Benv-B/photo-frame-hardware/hardware/iris_xiao_c5_revC/output/pcb/board_bottom.png

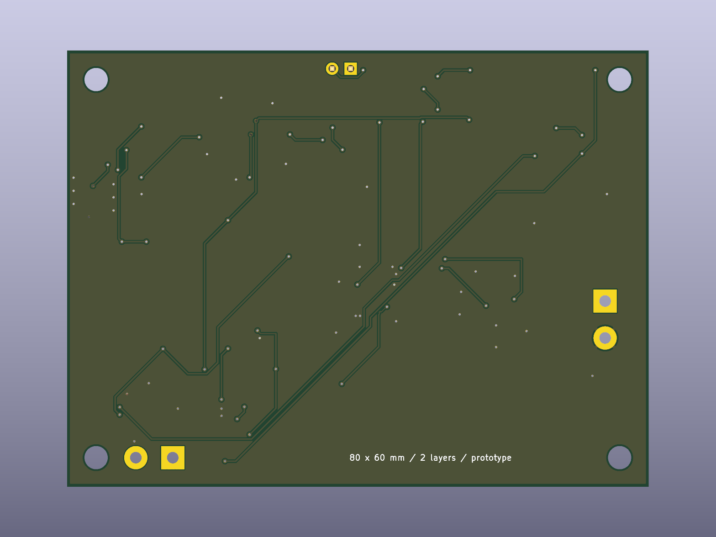
hardware/iris_xiao_c5_revC/output/pcb/board_bottom.png
