Benv-B/photo-frame-hardware/hardware/iris_xiao_c5_revC/output/pcb/bottom_copper.png

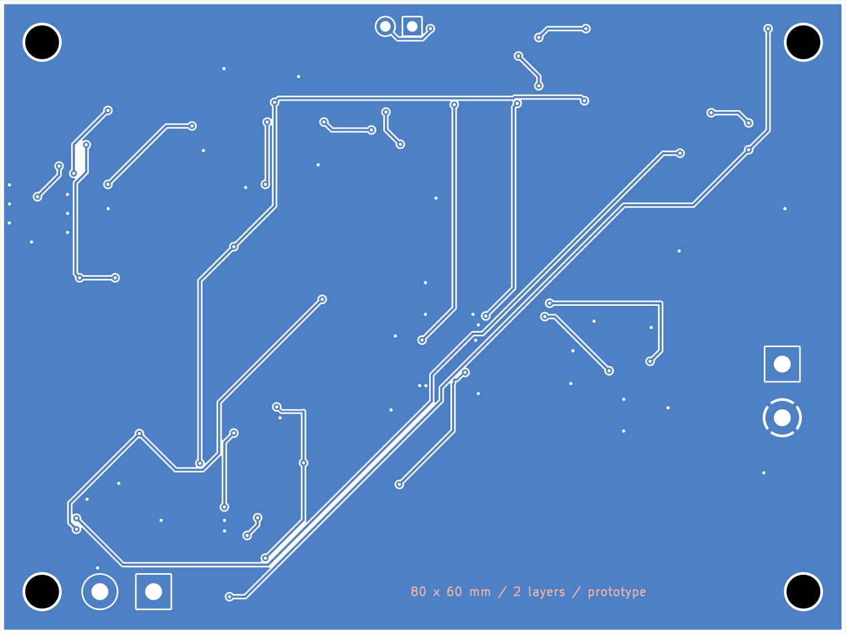
hardware/iris_xiao_c5_revC/output/pcb/bottom_copper.png
