Benv-B/photo-frame-hardware/hardware/iris_xiao_c5_revC/output/pcb/top_copper.png

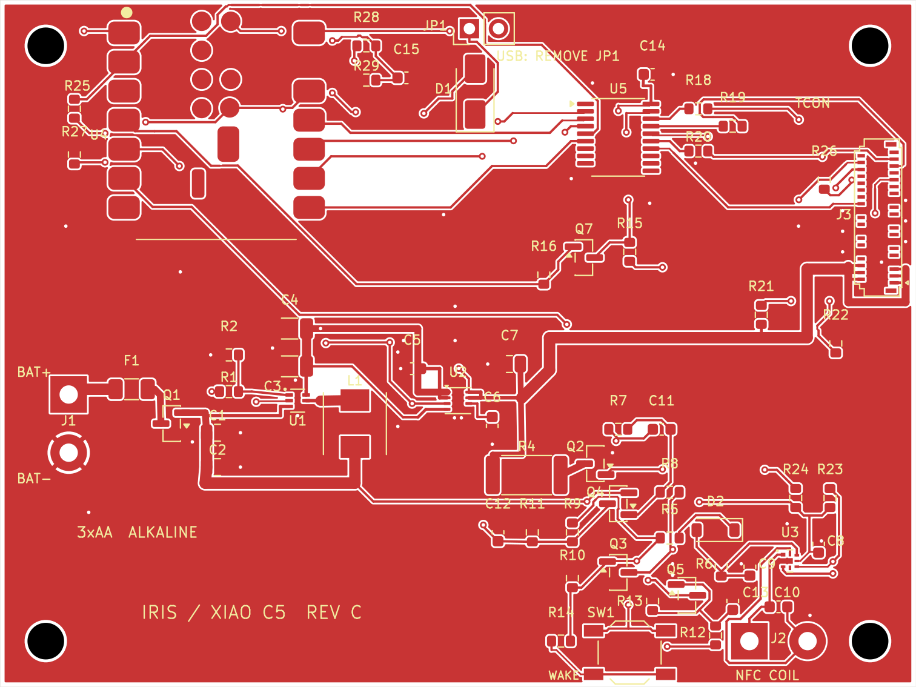
hardware/iris_xiao_c5_revC/output/pcb/top_copper.png
