Benv-B/photo-frame-hardware/hardware/iris_xiao_c5_revC/output/preview/page_1.png

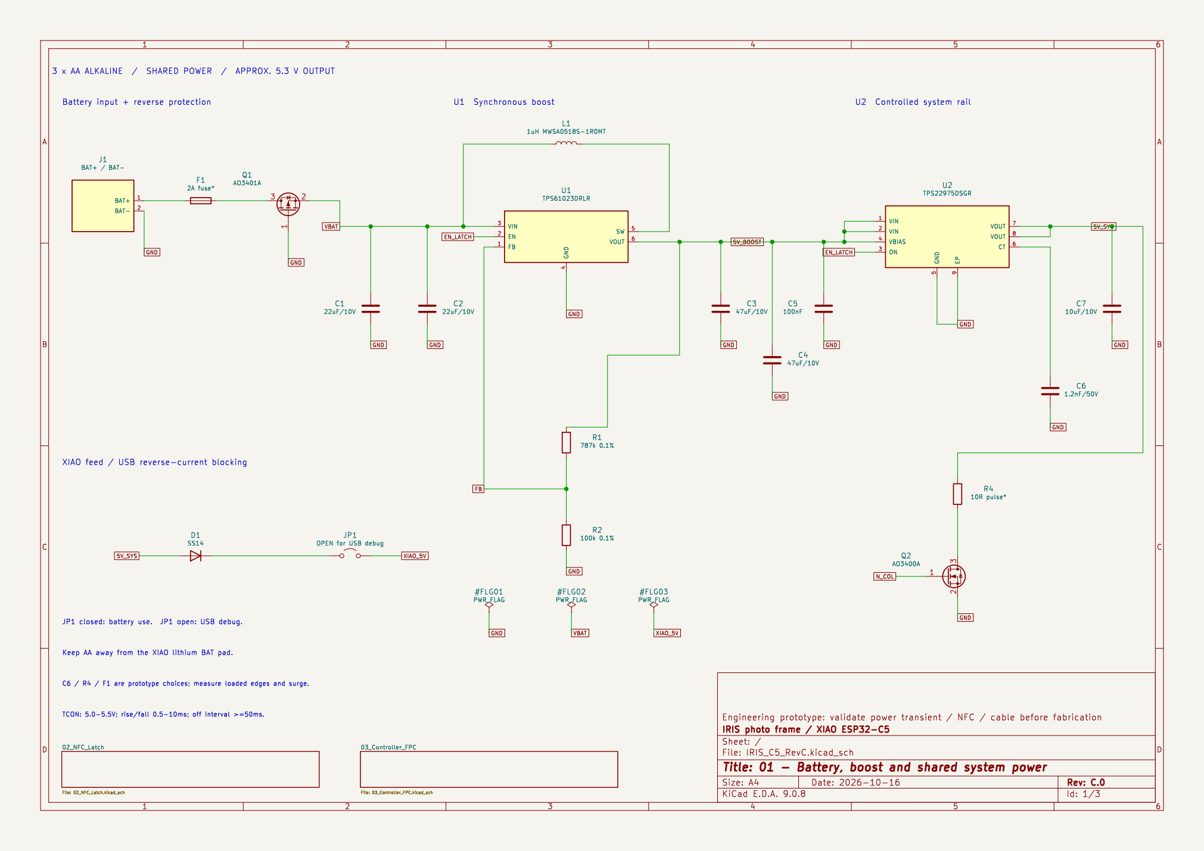
hardware/iris_xiao_c5_revC/output/preview/page_1.png
