Benv-B/photo-frame-hardware/hardware/iris_xiao_c5_revC/output/BOM.csv

Reference | Value | Footprint | Sheet | Notes
J1 | BAT+ / BAT- | IRIS_Local:Battery_Wire_2P | 1
F1 | 2A fuse* | Fuse:Fuse_1206_3216Metric | 1 | Candidate; verify fuse pulse I2t with measured TCON inrush
Q1 | AO3401A | Package_TO_SOT_SMD:SOT-23 | 1 | Reverse polarity protection: source is protected side
U1 | TPS61023DRLR | IRIS_Local:TI_DRL0006A | 1 | C919459; six-pin TI DRL0006A; no PG; 0.595V nominal feedback
L1 | 1uH MWSA0518S-1R0MT | IRIS_Local:Sunlord_MWSA0518S | 1 | C408343; Sunlord, Irms 8A, Isat 9A, DCR17mOhm; original land pattern
C1 | 22uF/10V | Capacitor_SMD:C_0805_2012Metric | 1
C2 | 22uF/10V | Capacitor_SMD:C_0805_2012Metric | 1
U2 | TPS22975DSGR | IRIS_Local:Texas_DSG0008A_WSON-8-1EP_2x2mm_P0.5mm_EP0.9x1.6mm | 1 | ON follows hardware latch directly; no power-good detector
C3 | 47uF/10V | Capacitor_SMD:C_1206_3216Metric | 1
C4 | 47uF/10V | Capacitor_SMD:C_1206_3216Metric | 1
C5 | 100nF | Capacitor_SMD:C_0603_1608Metric | 1
R1 | 787k 0.1% | Resistor_SMD:R_0603_1608Metric | 1 | PWM nominal 5.27765V; PFM nominal +1% ~5.33V
R2 | 100k 0.1% | Resistor_SMD:R_0603_1608Metric | 1
C7 | 10uF/10V | Capacitor_SMD:C_0805_2012Metric | 1
C6 | 1.2nF/50V | Capacitor_SMD:C_0603_1608Metric | 1
R4 | 10R pulse* | Resistor_SMD:R_2512_6332Metric | 1 | Pulse energy includes C*V^2/2 plus supply/discharge overlap (~2.76mJ/ms); validate actual waveforms and resistor pulse curve
Q2 | AO3400A | Package_TO_SOT_SMD:SOT-23 | 1 | N_COL high when latch OFF; verify discharge/load-switch order
D1 | SS14 | Diode_SMD:D_SMA | 1 | Anode at SYS; cathode toward XIAO. Blocks USB backfeed to SYS.
JP1 | OPEN for USB debug | Connector_PinHeader_2.54mm:PinHeader_1x02_P2.54mm_Vertical | 1
J2 | Tuned 13.56MHz coil | IRIS_Local:Battery_Wire_2P | 2 | Remote antenna; tune with screen/enclosure/ferrite
U3 | NT3H2111W0FHKH | IRIS_Local:NXP_SOT902-3_XQFN8_1.6x1.6mm | 2 | C710403; SOT902-3 XQFN8; no center solder pad; FD unused
C10 | DNP / tune | Capacitor_SMD:C_0603_1608Metric | 2
C8 | 100nF | Capacitor_SMD:C_0603_1608Metric | 2
R24 | 4.7k | Resistor_SMD:R_0603_1608Metric | 2
R23 | 4.7k | Resistor_SMD:R_0603_1608Metric | 2
C9 | 180nF* | Capacitor_SMD:C_0603_1608Metric | 2
R6 | 470k | Resistor_SMD:R_0603_1608Metric | 2
D2 | 1N4148W | Diode_SMD:D_SOD-123 | 2
R5 | 22k | Resistor_SMD:R_0603_1608Metric | 2
Q3 | BC847B | Package_TO_SOT_SMD:SOT-23 | 2
Q4 | BC857C | Package_TO_SOT_SMD:SOT-23 | 2
R8 | 47k | Resistor_SMD:R_0603_1608Metric | 2
R7 | 100k | Resistor_SMD:R_0603_1608Metric | 2
C11 | 47nF | Capacitor_SMD:C_0603_1608Metric | 2
R9 | 100k | Resistor_SMD:R_0603_1608Metric | 2
R10 | 100k | Resistor_SMD:R_0603_1608Metric | 2
R11 | 100k | Resistor_SMD:R_0603_1608Metric | 2
C12 | 10nF | Capacitor_SMD:C_0603_1608Metric | 2
SW1 | WAKE | Button_Switch_SMD:SW_SPST_TL3342 | 2
R14 | 100k | Resistor_SMD:R_0603_1608Metric | 2
Q5 | BC847B / CLEAR | Package_TO_SOT_SMD:SOT-23 | 2
R12 | 10k | Resistor_SMD:R_0603_1608Metric | 2
R13 | 100k | Resistor_SMD:R_0603_1608Metric | 2
C13 | 100nF | Capacitor_SMD:C_0603_1608Metric | 2
R27 | 100k | Resistor_SMD:R_0603_1608Metric | 2
U4 | XIAO ESP32-C5 V1.1 | IRIS_Local:XIAO-ESP32-C5-SMD | 3
U5 | SN74CB3Q3245PWR | Package_SO:TSSOP-20_4.4x6.5mm_P0.65mm | 3
J3 | FH26W-39S-0.3SHW(60) | IRIS_Local:Hirose_FH26-39S-0.3SHW_2Rows-39Pins-1MP_P0.60mm_Horizontal | 3
R25 | 47k | Resistor_SMD:R_0603_1608Metric | 3
R28 | 1M | Resistor_SMD:R_0603_1608Metric | 3
R29 | 330k | Resistor_SMD:R_0603_1608Metric | 3
C15 | 100nF | Capacitor_SMD:C_0603_1608Metric | 3
C14 | 100nF | Capacitor_SMD:C_0603_1608Metric | 3
R18 | 33R | Resistor_SMD:R_0603_1608Metric | 3
R19 | 33R | Resistor_SMD:R_0603_1608Metric | 3
R20 | 33R | Resistor_SMD:R_0603_1608Metric | 3
R15 | 47k | Resistor_SMD:R_0603_1608Metric | 3
Q7 | 2N7002 | Package_TO_SOT_SMD:SOT-23 | 3
R16 | 100k | Resistor_SMD:R_0603_1608Metric | 3
R26 | 100k | Resistor_SMD:R_0603_1608Metric | 3
R21 | 100k | Resistor_SMD:R_0603_1608Metric | 3
R22 | 150k | Resistor_SMD:R_0603_1608Metric | 3
