Benv-B/photo-frame-hardware/hardware/iris_xiao_c5_revC/validation/nfc_latch/latch_validation.png

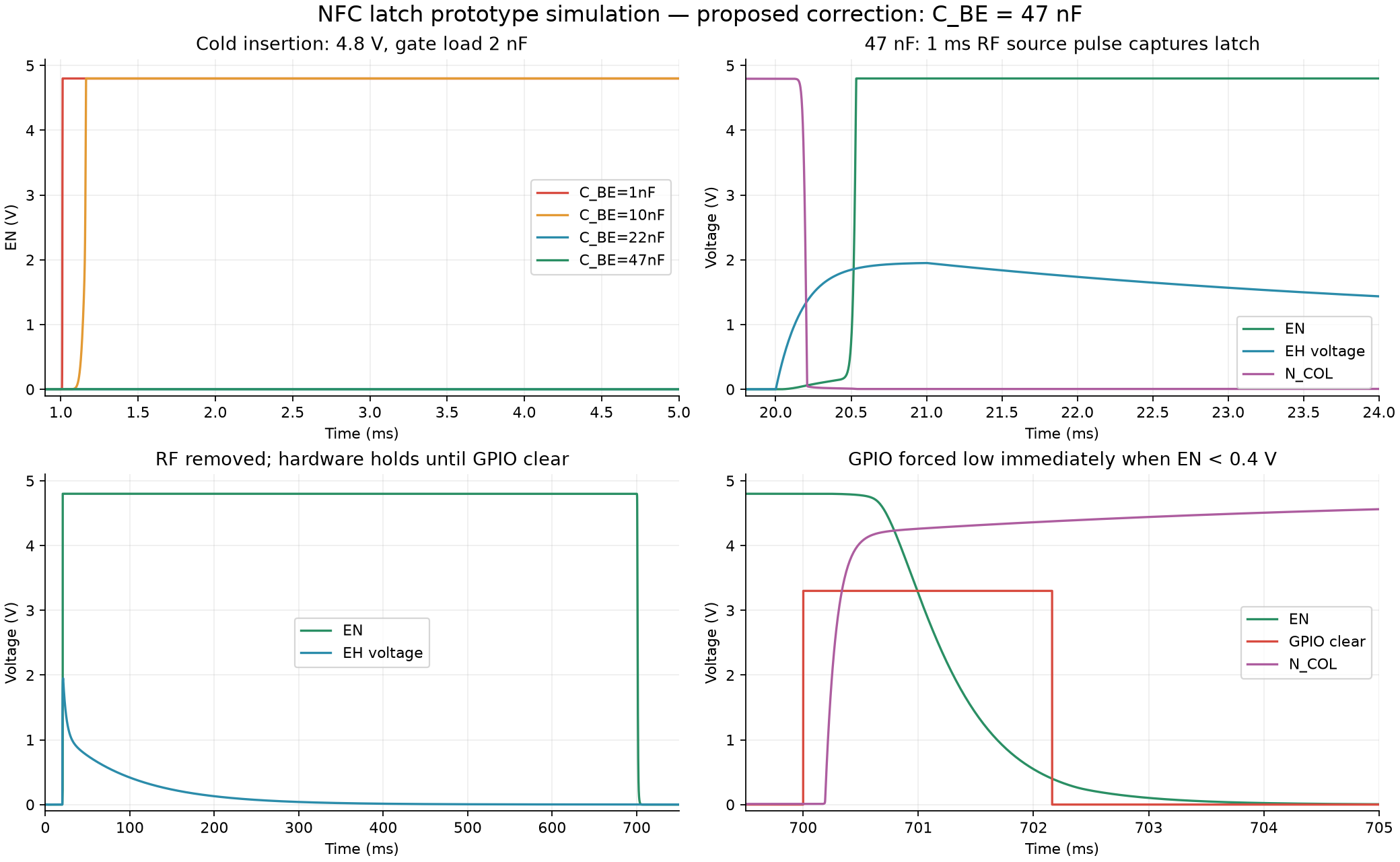
hardware/iris_xiao_c5_revC/validation/nfc_latch/latch_validation.png
