Benv-B/photo-frame-hardware/hardware/iris_xiao_c5_revC/output/IRIS_C5_RevC_schematic.pdf

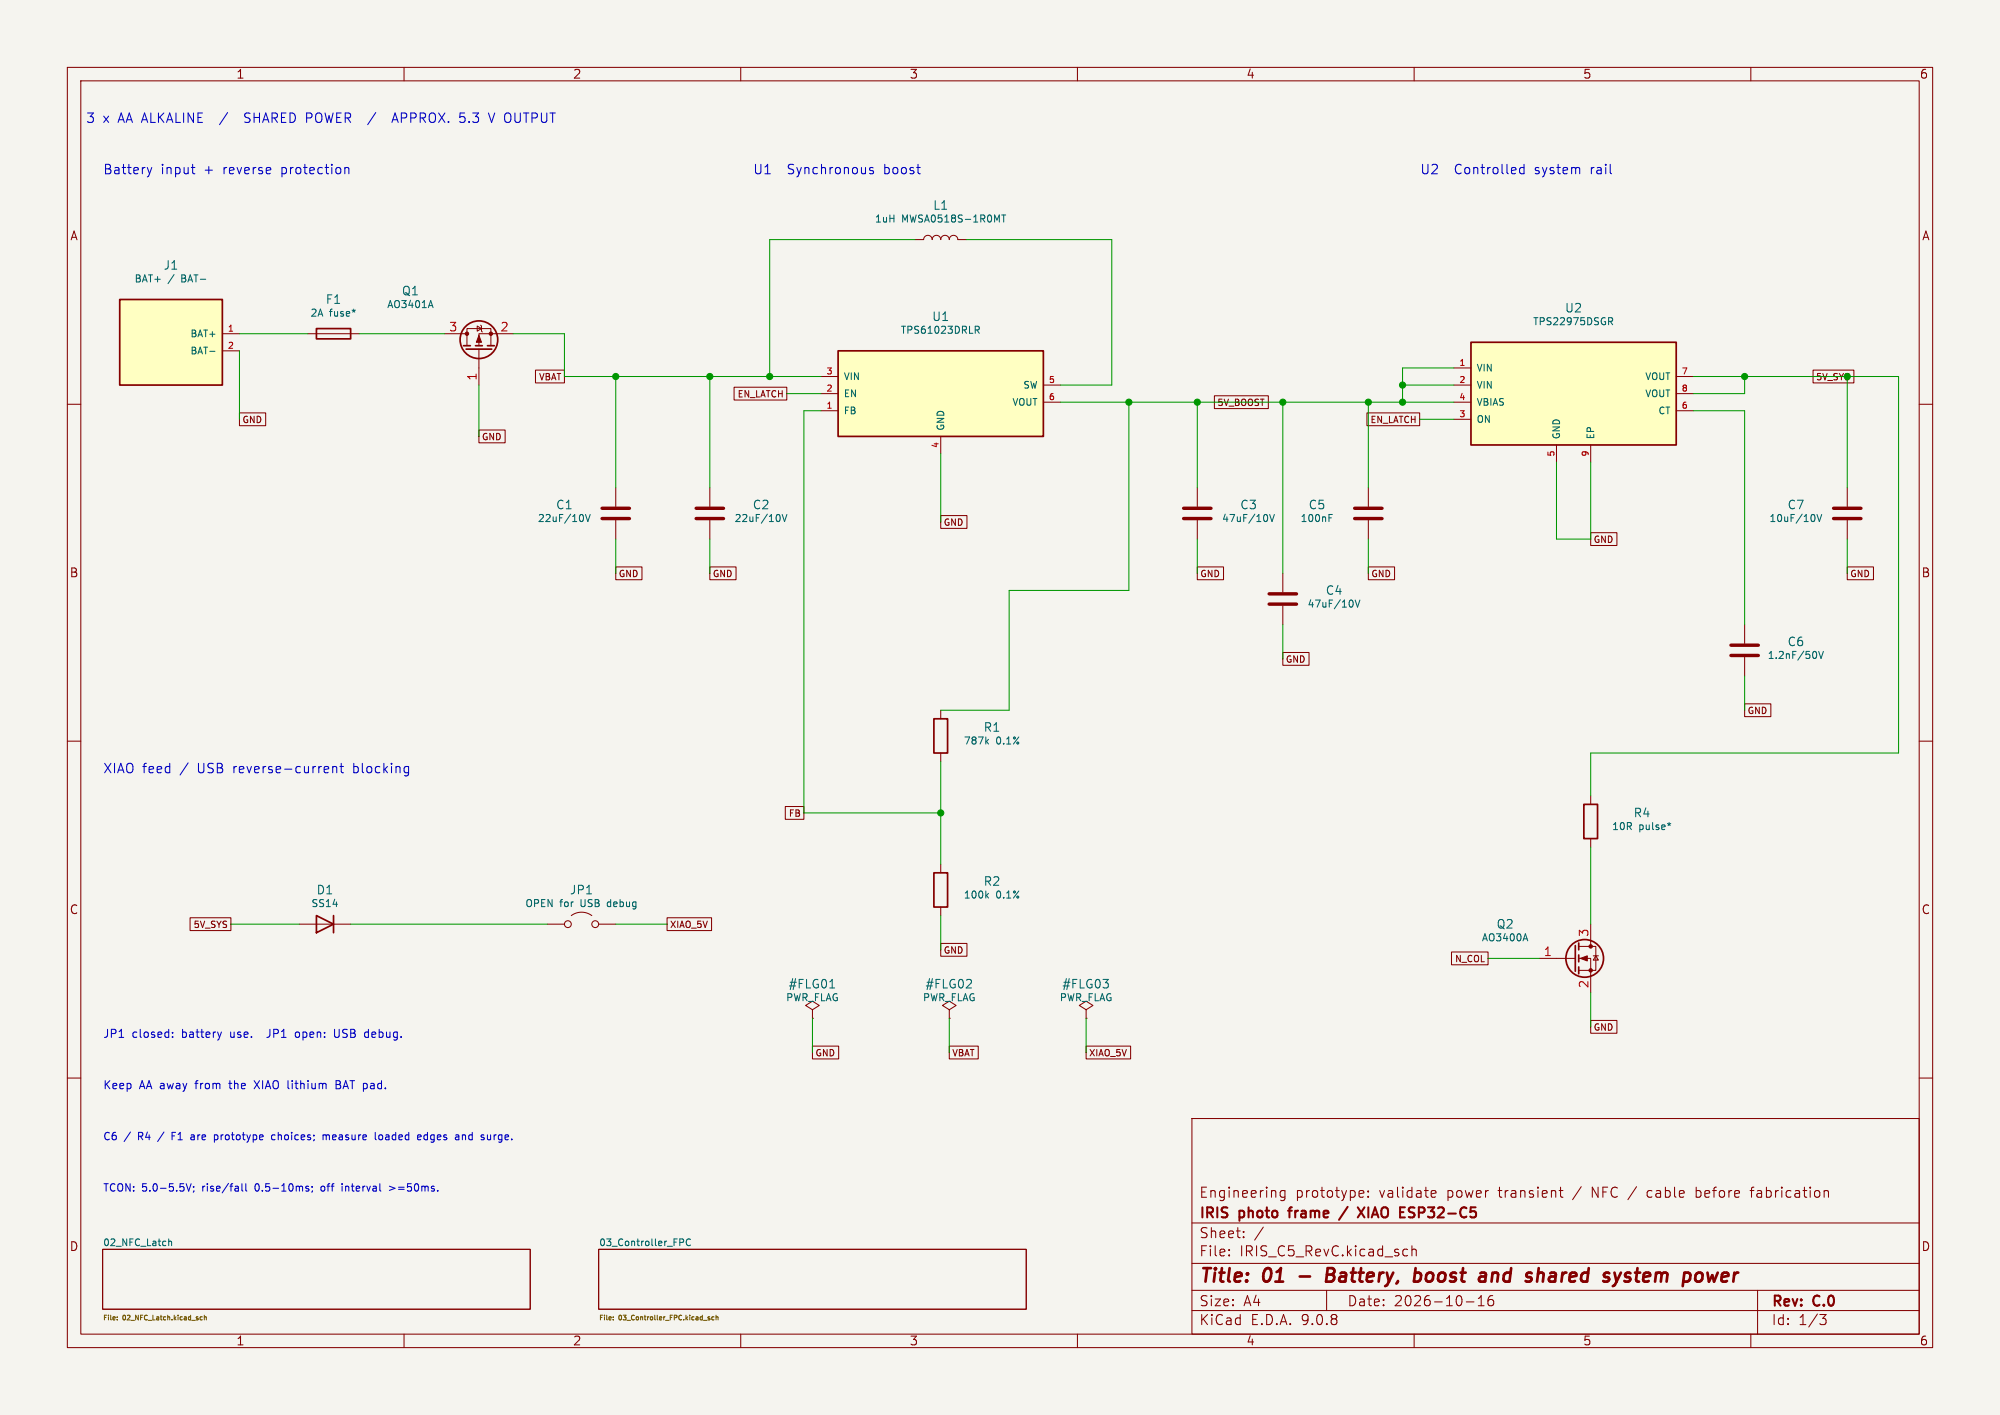
[picture p9: page 1]

Id: 1/3 Title: 01 - Battery, boost and shared system power File: IRIS_C5_RevC.kicad_sch Sheet: /

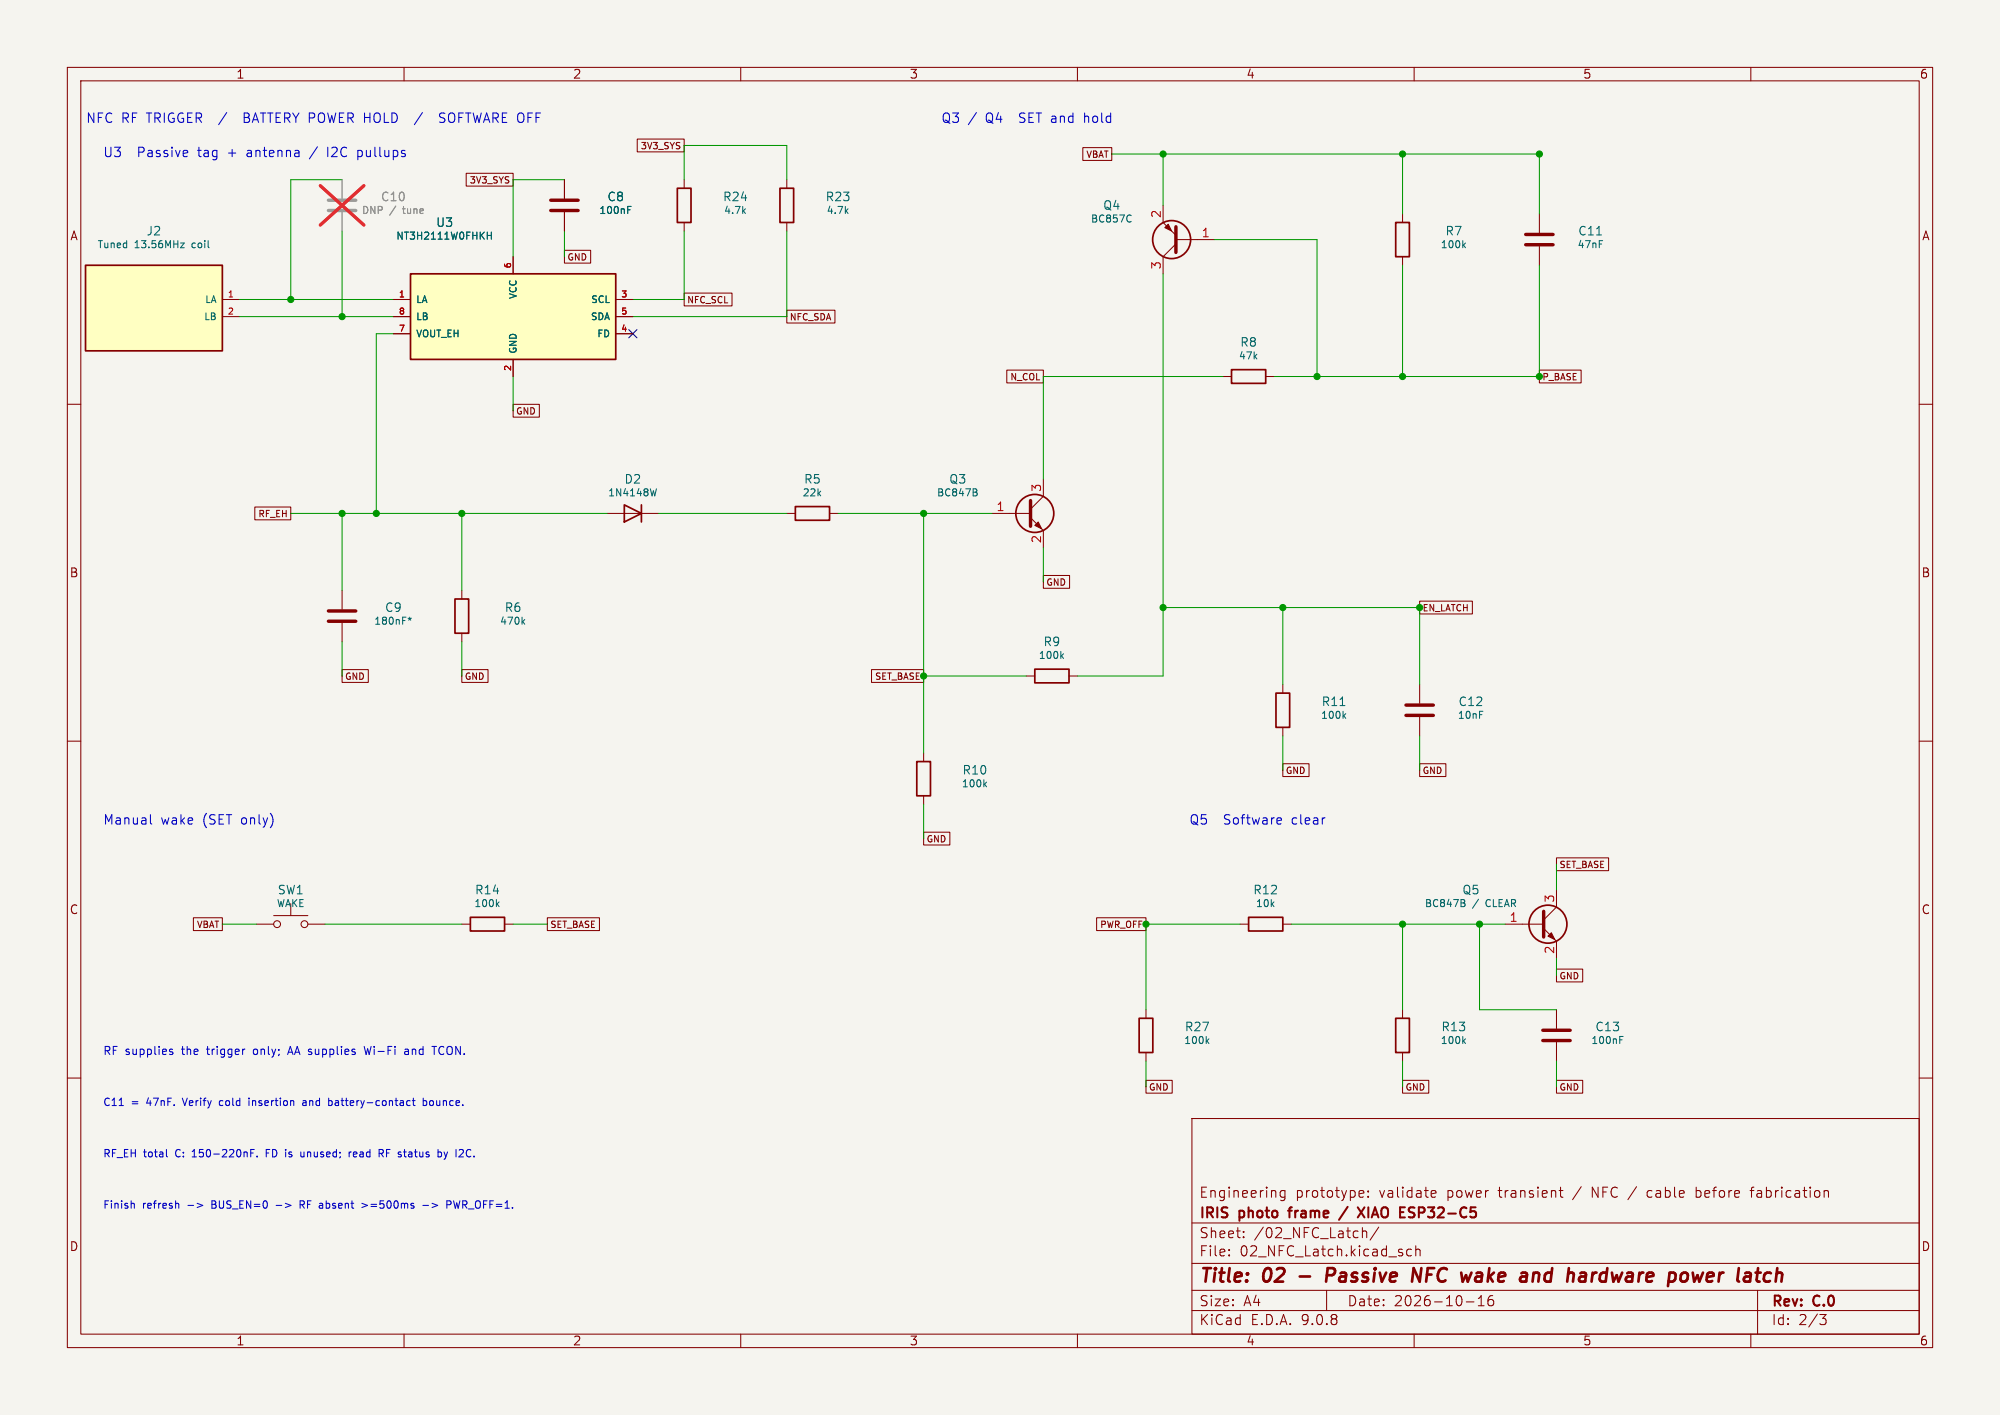
[picture p10: page 2]

File: 02_NFC_Latch.kicad_sch Sheet: /02_NFC_Latch/
Id: 2/3 Title: 02 - Passive NFC wake and hardware power latch

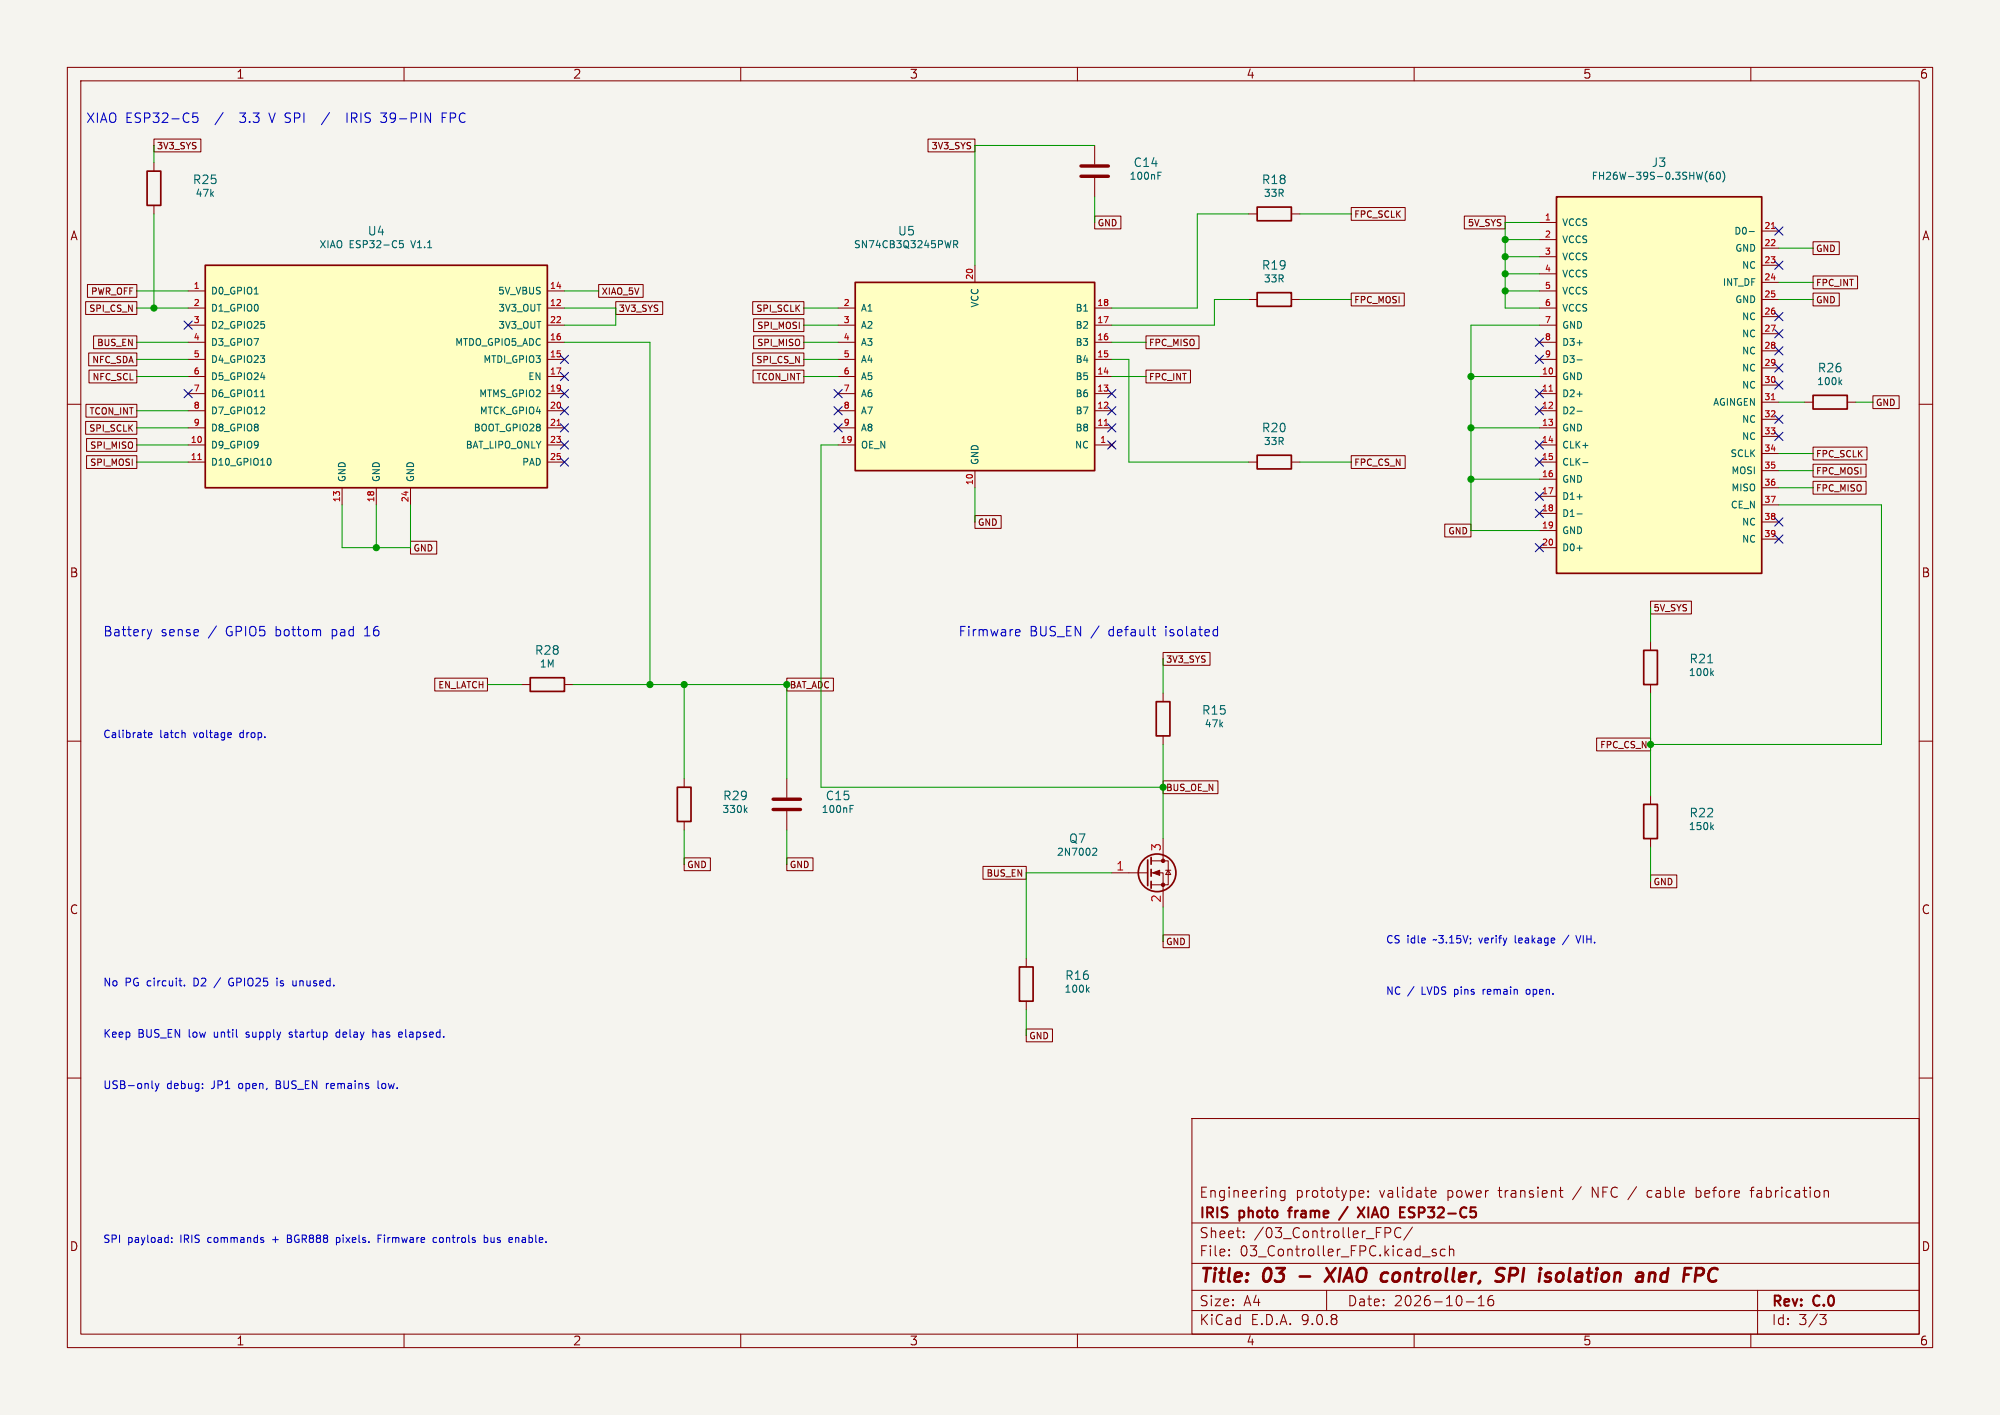
[picture p11: page 3]

INT_DF 24 GND 25 NC 26 NC 27 NC 28 NC 29 NC 30 AGINGEN 31 NC 32 NC 33 SCLK 34 MOSI 35 MISO 36 CE_N 37 NC 38 NC 39 J3
