Benv-B/photo-frame-hardware/hardware/iris_xiao_c5_revC/IRIS_C5_RevC.kicad_pcb

## KiCad design hardware/iris_xiao_c5_revC/IRIS_C5_RevC.kicad_pcb (2026-10-16)

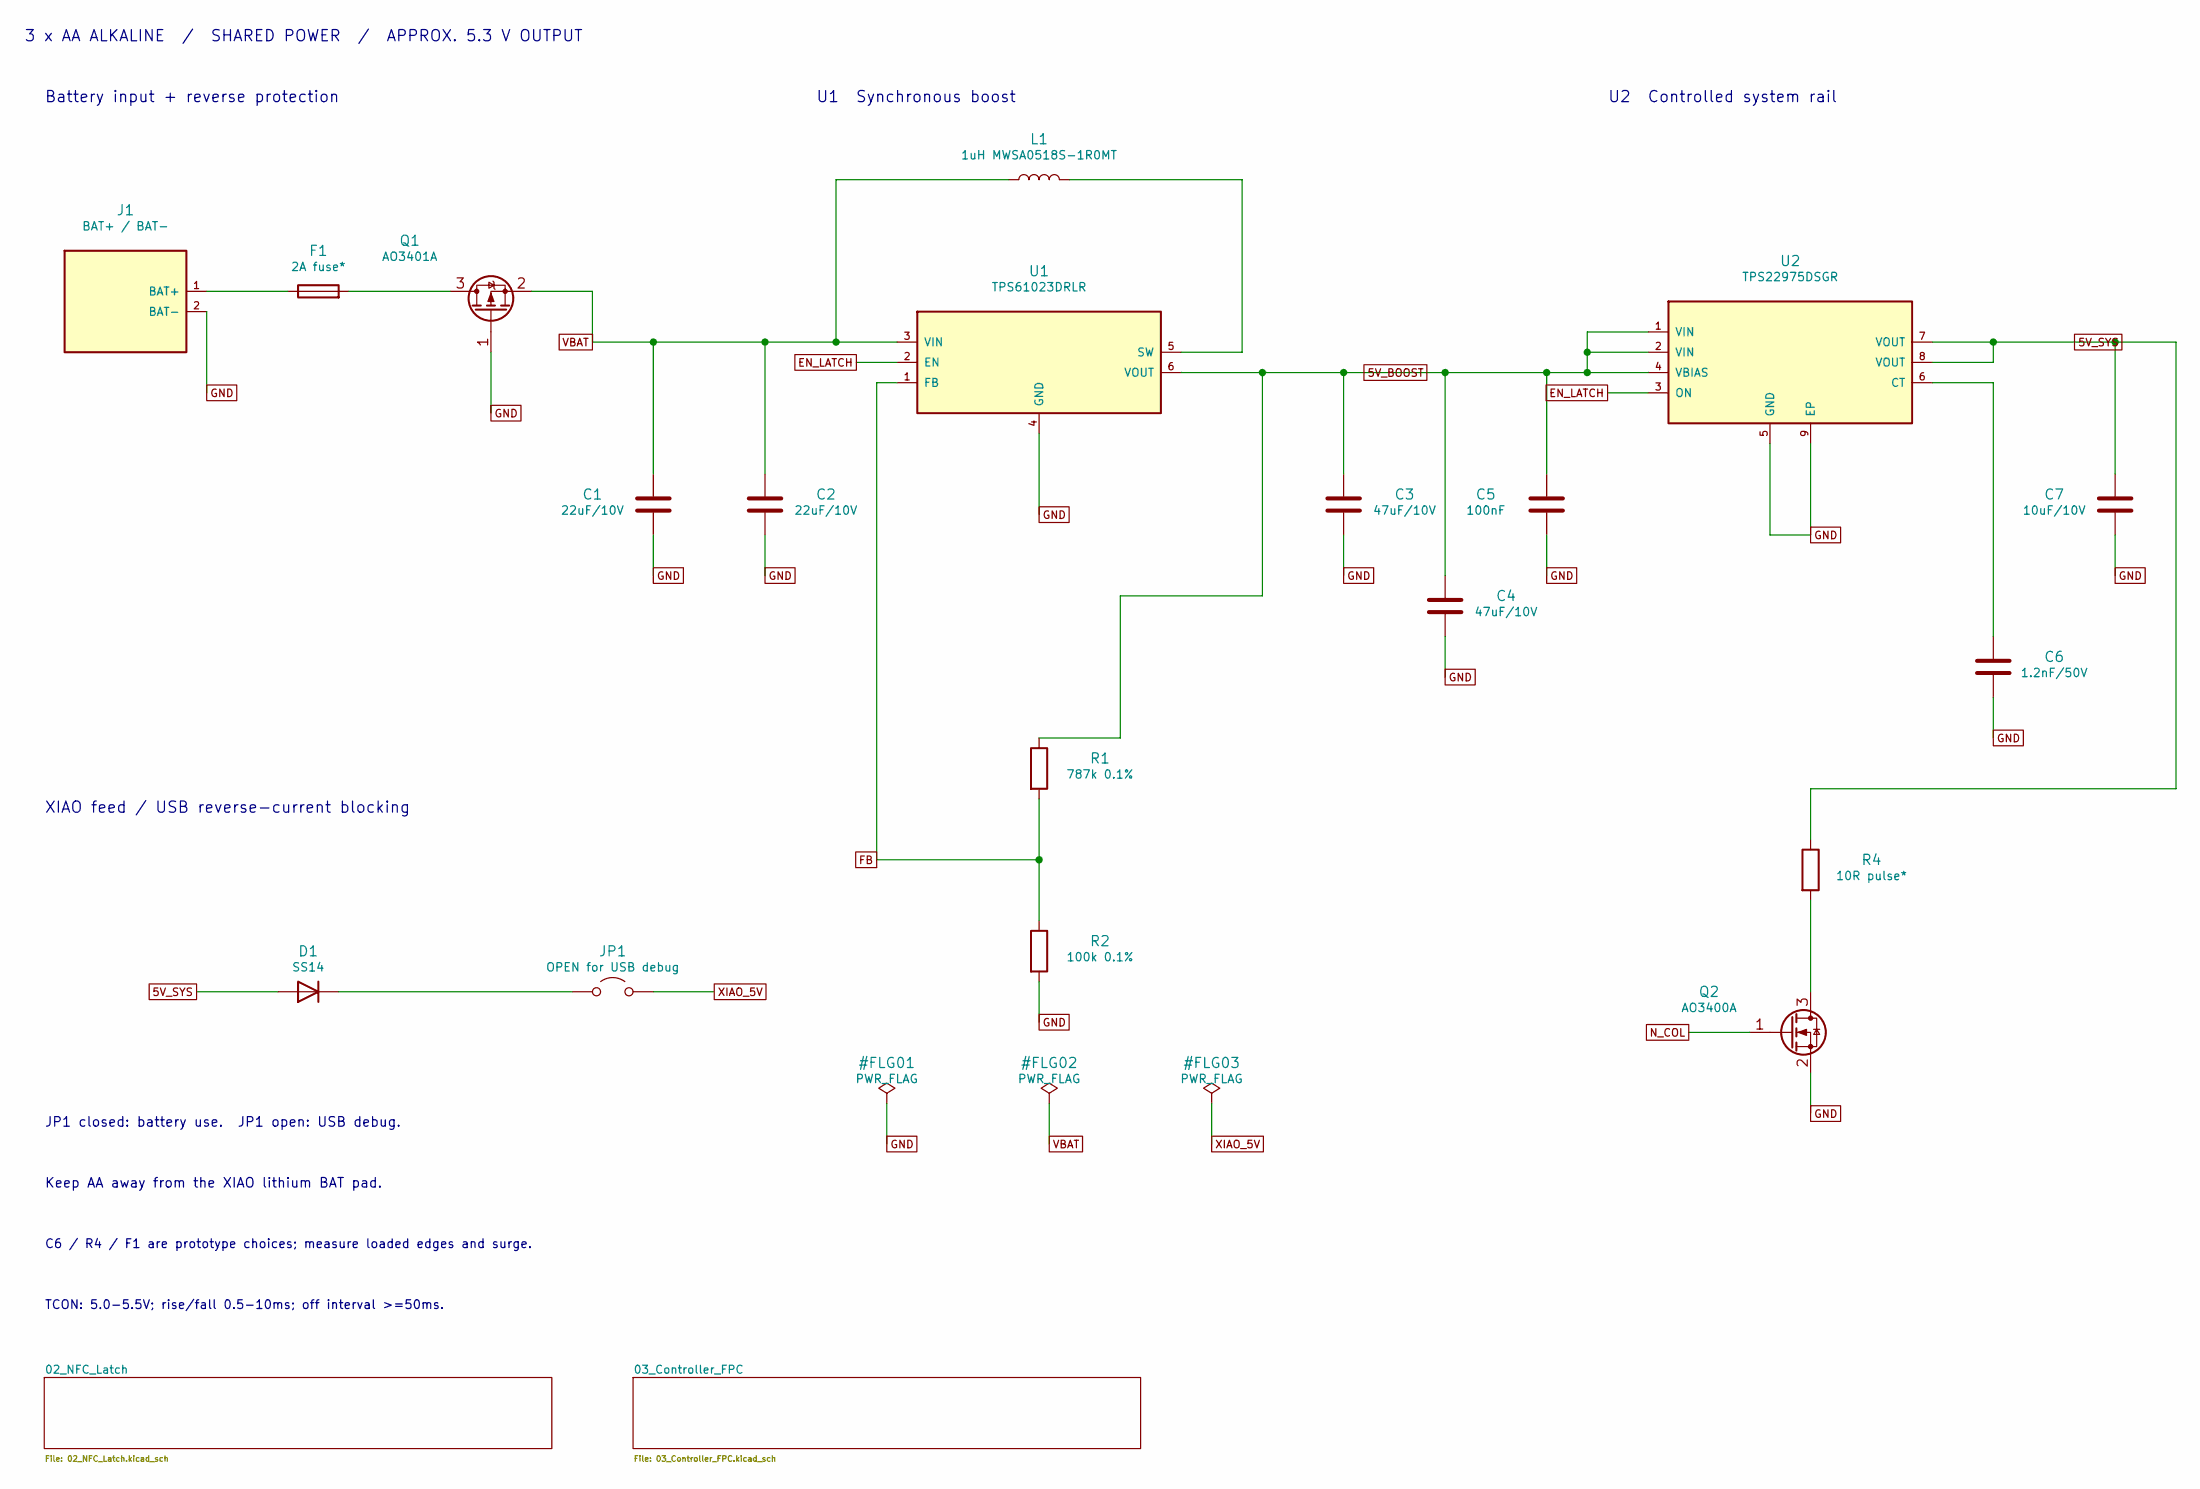
[picture p12: schematic IRIS_C5_RevC.kicad_sch, 01 - Battery, boost and shared system power]

Parts:
C1, C2: 22uF/10V; C_0805_2012Metric
C3, C4: 47uF/10V; C_1206_3216Metric
C5: 100nF; C_0603_1608Metric
C6: 1.2nF/50V; C_0603_1608Metric
C7: 10uF/10V; C_0805_2012Metric
D1: SS14; D_SMA
F1: 2A fuse*; Fuse_1206_3216Metric
J1: BAT+ / BAT-; Battery_Wire_2P
JP1: OPEN for USB debug; PinHeader_1x02_P2.54mm_Vertical
L1: 1uH MWSA0518S-1R0MT; Sunlord_MWSA0518S
Q1: AO3401A; SOT-23
Q2: AO3400A; SOT-23
R1: 787k 0.1%; R_0603_1608Metric
R2: 100k 0.1%; R_0603_1608Metric
R4: 10R pulse*; R_2512_6332Metric
U1: TPS61023DRLR; TI_DRL0006A
U2: TPS22975DSGR; Texas_DSG0008A_WSON-8-1EP_2x2mm_P0.5mm_EP0.9x1.6mm

Connections:
5V_BOOST: C3.1, C4.1, C5.1, R1.1, U1.6 (VOUT), U2.1 (VIN), U2.2 (VIN), U2.4 (VBIAS)
5V_SYS: C7.1, D1.2 (A), R4.1, U2.7 (VOUT), U2.8 (VOUT); also elsewhere on the board
EN_LATCH: U1.2 (EN), U2.3 (ON); also elsewhere on the board
FB: R1.2, R2.1, U1.1 (FB)
GND: C1.2, C2.2, C3.2, C4.2, C5.2, C6.2, C7.2, J1.2 (BAT-), Q1.1 (G), Q2.2 (S), R2.2, U1.4 (GND), U2.5 (GND), U2.9 (EP); also elsewhere on the board
N_COL: Q2.1 (G); also elsewhere on the board
unnamed: D1.1 (K), JP1.1 (A)
unnamed: F1.1, J1.1 (BAT+)
unnamed: F1.2, Q1.3 (D)
unnamed: Q2.3 (D), R4.2
unnamed: L1.2, U1.5 (SW)
unnamed: C6.1, U2.6 (CT)
VBAT: C1.1, C2.1, L1.1, Q1.2 (S), U1.3 (VIN); also elsewhere on the board
XIAO_5V: JP1.2 (B); also elsewhere on the board

Notes on the sheet:
3 x AA ALKALINE / SHARED POWER / APPROX. 5.3 V OUTPUT
Battery input + reverse protection
U1 Synchronous boost
U2 Controlled system rail
XIAO feed / USB reverse-current blocking
JP1 closed: battery use. JP1 open: USB debug.
Keep AA away from the XIAO lithium BAT pad.
C6 / R4 / F1 are prototype choices; measure loaded edges and surge.
TCON: 5.0-5.5V; rise/fall 0.5-10ms; off interval >=50ms.

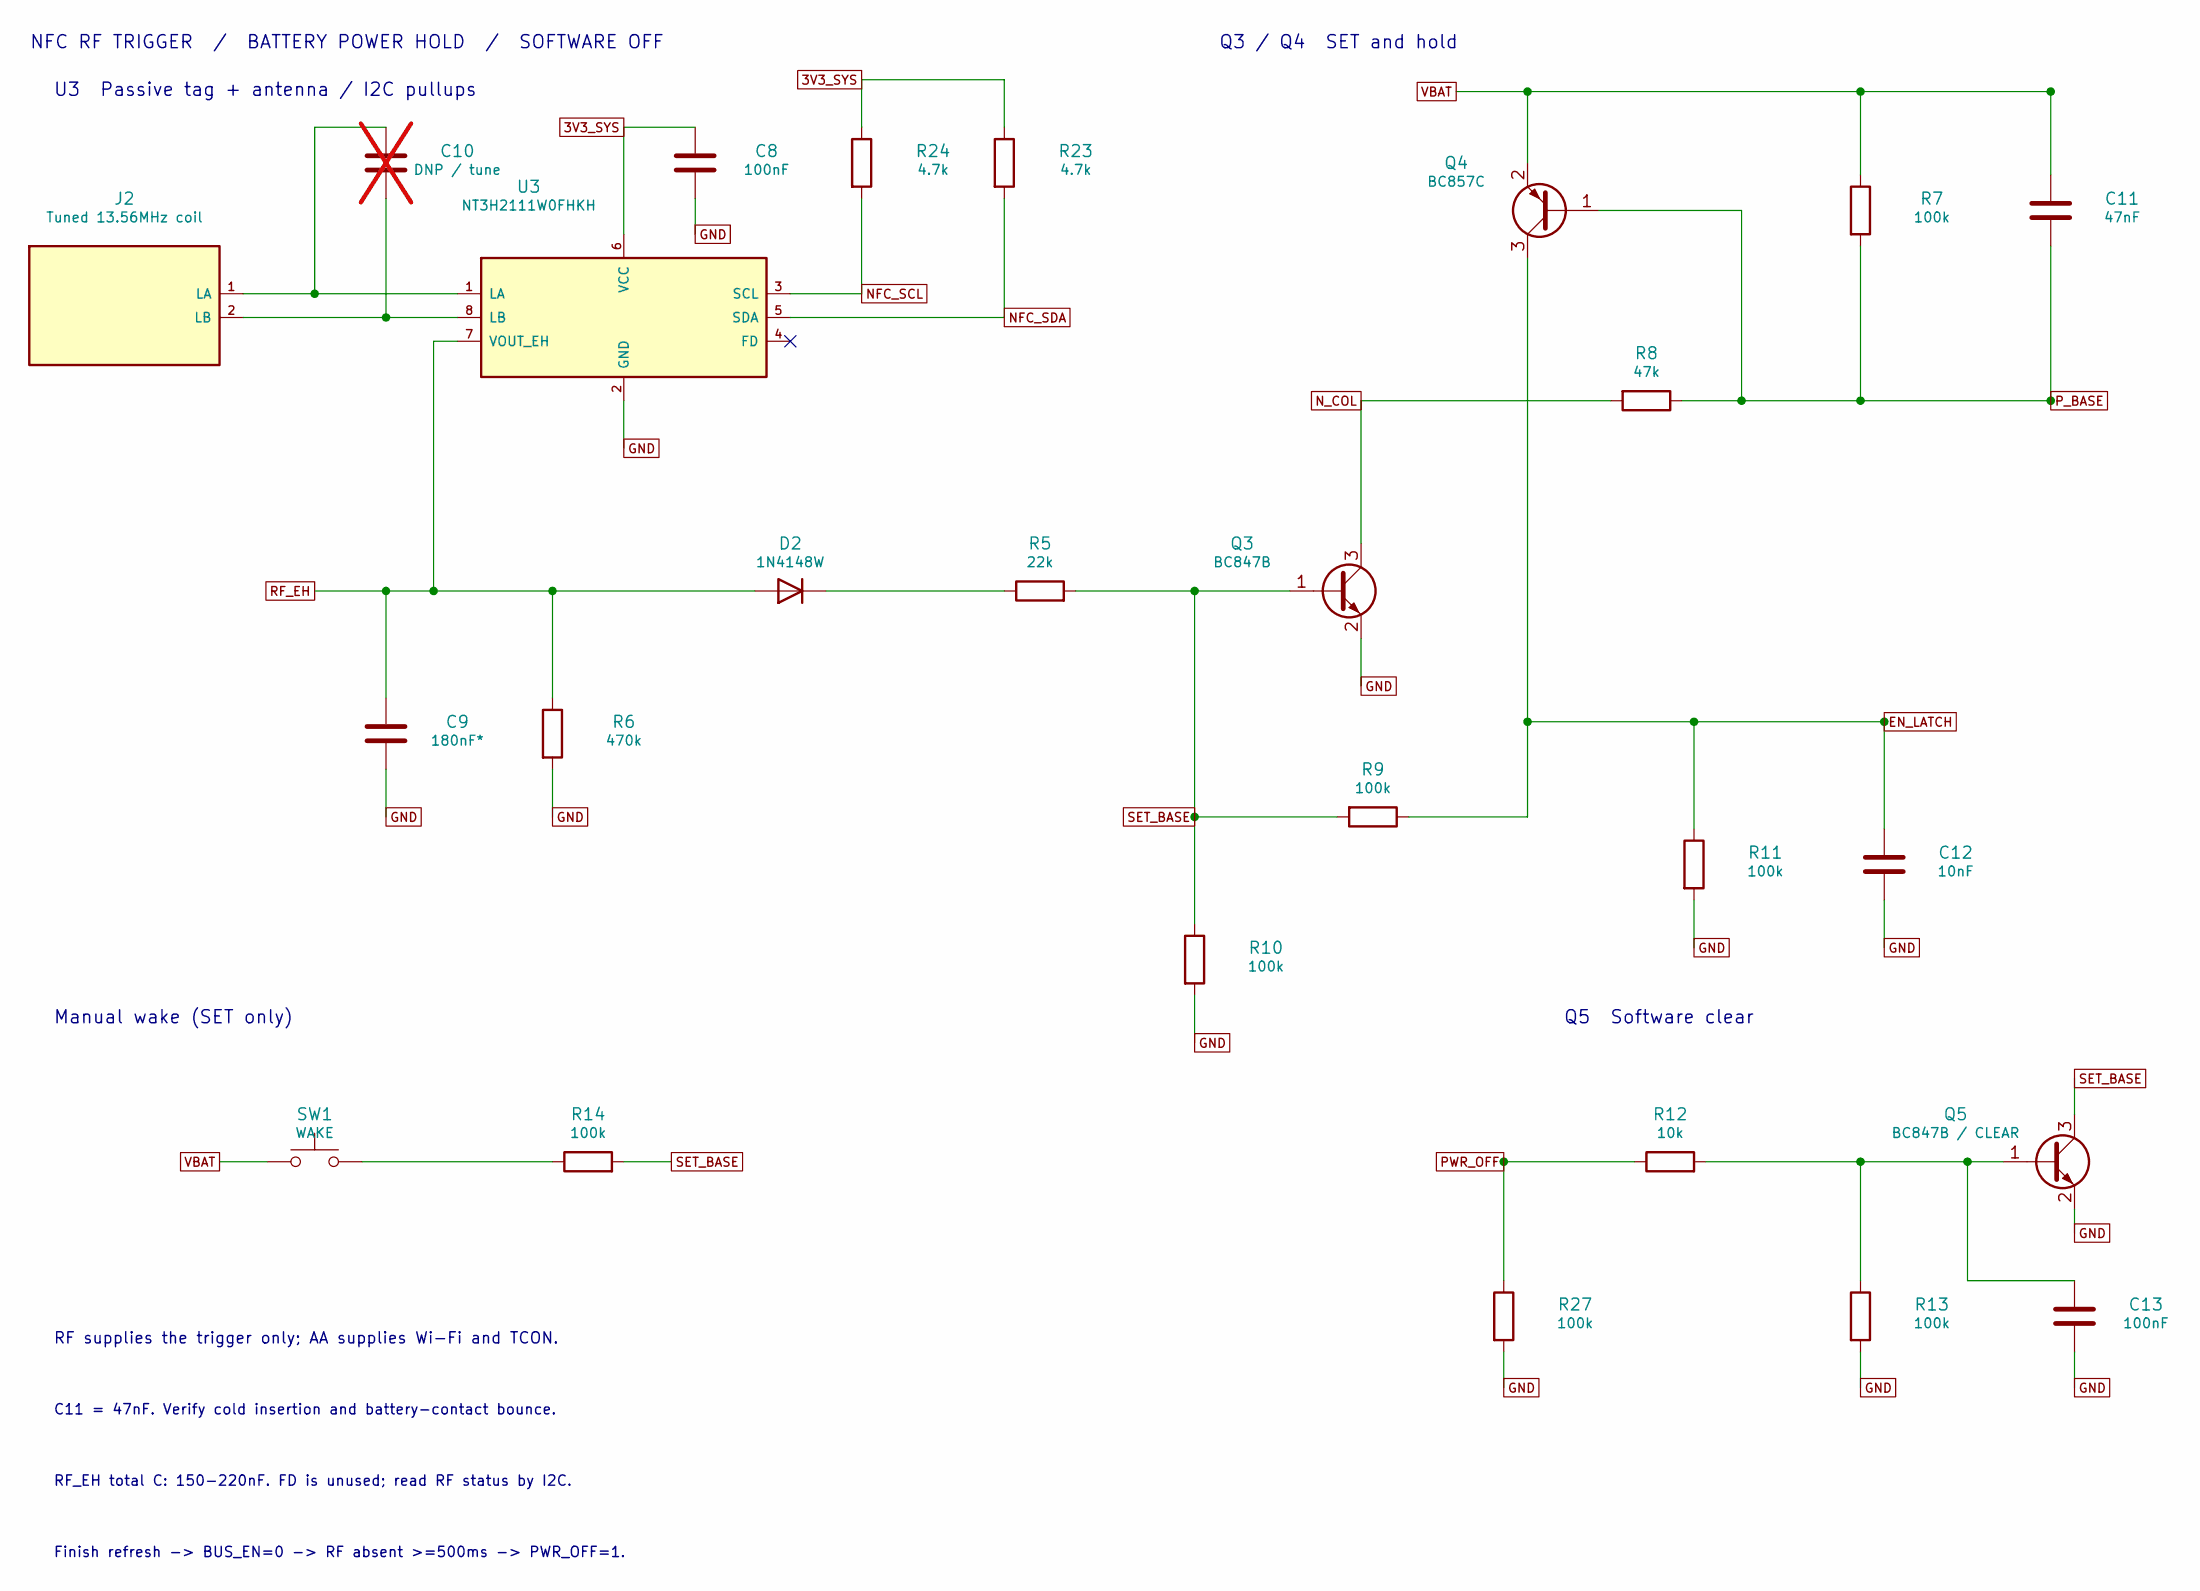
[picture p13: schematic 02_NFC_Latch.kicad_sch, 02 - Passive NFC wake and hardware power latch]

Parts:
C8, C13: 100nF; C_0603_1608Metric
C9: 180nF*; C_0603_1608Metric
C10: DNP / tune; C_0603_1608Metric; not fitted
C11: 47nF; C_0603_1608Metric
C12: 10nF; C_0603_1608Metric
D2: 1N4148W; D_SOD-123
J2: Tuned 13.56MHz coil; Battery_Wire_2P
Q3: BC847B; SOT-23
Q4: BC857C; SOT-23
Q5: BC847B / CLEAR; SOT-23
R5: 22k; R_0603_1608Metric
R6: 470k; R_0603_1608Metric
R7, R9, R10, R11, R13, R14, R27: 100k; R_0603_1608Metric
R8: 47k; R_0603_1608Metric
R12: 10k; R_0603_1608Metric
R23, R24: 4.7k; R_0603_1608Metric
SW1: WAKE; SW_SPST_TL3342
U3: NT3H2111W0FHKH; NXP_SOT902-3_XQFN8_1.6x1.6mm

Connections:
3V3_SYS: C8.1, R23.1, R24.1, U3.6 (VCC); also elsewhere on the board
EN_LATCH: C12.1, Q4.3 (C), R9.1, R11.1; also elsewhere on the board
GND: C8.2, C9.2, C12.2, C13.2, Q3.2 (E), Q5.2 (E), R6.2, R10.2, R11.2, R13.2, R27.2, U3.2 (GND); also elsewhere on the board
NFC_SCL: R24.2, U3.3 (SCL); also elsewhere on the board
NFC_SDA: R23.2, U3.5 (SDA); also elsewhere on the board
N_COL: Q3.3 (C), R8.2; also elsewhere on the board
unnamed: D2.1 (K), R5.1
unnamed: C10.1, J2.1 (LA), U3.1 (LA)
unnamed: C10.2, J2.2 (LB), U3.8 (LB)
unnamed: C13.1, Q5.1 (B), R12.2, R13.1
unnamed: R14.1, SW1.2
PWR_OFF: R12.1, R27.1; also elsewhere on the board
P_BASE: C11.2, Q4.1 (B), R7.2, R8.1
RF_EH: C9.1, D2.2 (A), R6.1, U3.7 (VOUT_EH)
SET_BASE: Q3.1 (B), Q5.3 (C), R5.2, R9.2, R10.1, R14.2
VBAT: C11.1, Q4.2 (E), R7.1, SW1.1; also elsewhere on the board

Notes on the sheet:
NFC RF TRIGGER / BATTERY POWER HOLD / SOFTWARE OFF
U3 Passive tag + antenna / I2C pullups
Q3 / Q4 SET and hold
Manual wake (SET only)
Q5 Software clear
RF supplies the trigger only; AA supplies Wi-Fi and TCON.
C11 = 47nF. Verify cold insertion and battery-contact bounce.
RF_EH total C: 150-220nF. FD is unused; read RF status by I2C.
Finish refresh -> BUS_EN=0 -> RF absent >=500ms -> PWR_OFF=1.

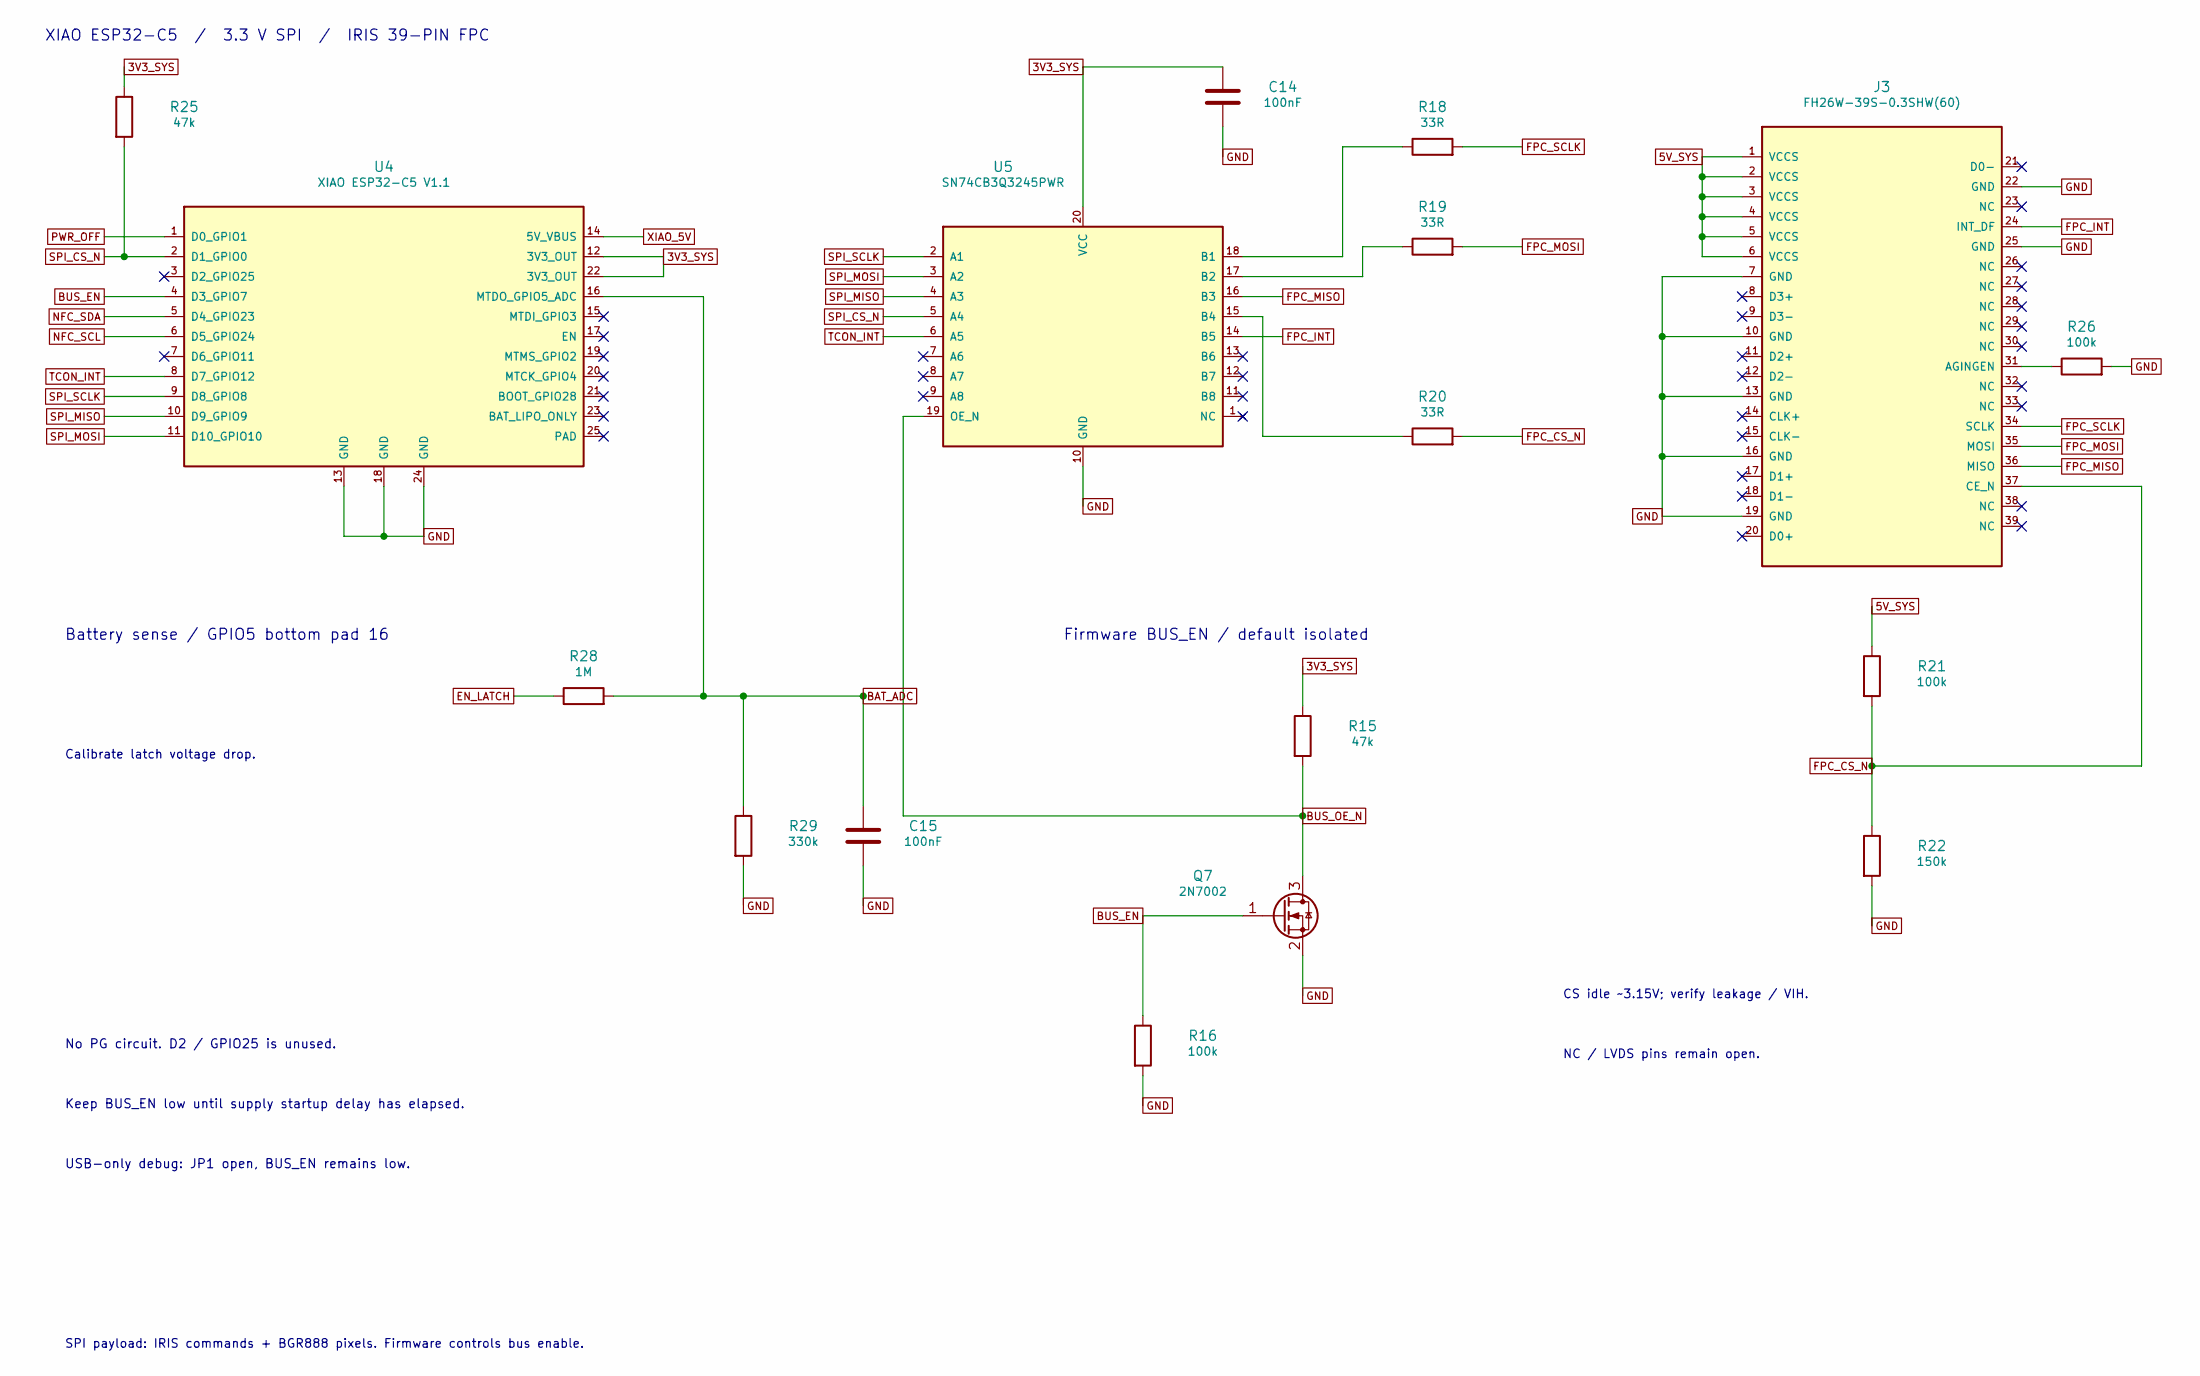
[picture p14: schematic 03_Controller_FPC.kicad_sch, 03 - XIAO controller, SPI isolation and FPC]

Parts:
C14, C15: 100nF; C_0603_1608Metric
J3: FH26W-39S-0.3SHW(60); Hirose_FH26-39S-0.3SHW_2Rows-39Pins-1MP_P0.60mm_Horizontal
Q7: 2N7002; SOT-23
R15, R25: 47k; R_0603_1608Metric
R16, R21, R26: 100k; R_0603_1608Metric
R18, R19, R20: 33R; R_0603_1608Metric
R22: 150k; R_0603_1608Metric
R28: 1M; R_0603_1608Metric
R29: 330k; R_0603_1608Metric
U4: XIAO ESP32-C5 V1.1; XIAO-ESP32-C5-SMD
U5: SN74CB3Q3245PWR; TSSOP-20_4.4x6.5mm_P0.65mm

Connections:
3V3_SYS: C14.1, R15.1, R25.1, U4.12 (3V3_OUT), U4.22 (3V3_OUT), U5.20 (VCC); also elsewhere on the board
5V_SYS: J3.1 (VCCS), J3.2 (VCCS), J3.3 (VCCS), J3.4 (VCCS), J3.5 (VCCS), J3.6 (VCCS), R21.1; also elsewhere on the board
BAT_ADC: C15.1, R28.2, R29.1, U4.16 (MTDO_GPIO5_ADC)
BUS_EN: Q7.1 (G), R16.1, U4.4 (D3_GPIO7)
BUS_OE_N: Q7.3 (D), R15.2, U5.19 (OE_N)
EN_LATCH: R28.1; also elsewhere on the board
FPC_CS_N: J3.37 (CE_N), R20.2, R21.2, R22.1
FPC_INT: J3.24 (INT_DF), U5.14 (B5)
FPC_MISO: J3.36 (MISO), U5.16 (B3)
FPC_MOSI: J3.35 (MOSI), R19.2
FPC_SCLK: J3.34 (SCLK), R18.2
GND: C14.2, C15.2, J3.7 (GND), J3.10 (GND), J3.13 (GND), J3.16 (GND), J3.19 (GND), J3.22 (GND), J3.25 (GND), Q7.2 (S), R16.2, R22.2, R26.2, R29.2, U4.13 (GND), U4.18 (GND), U4.24 (GND), U5.10 (GND); also elsewhere on the board
NFC_SCL: U4.6 (D5_GPIO24); also elsewhere on the board
NFC_SDA: U4.5 (D4_GPIO23); also elsewhere on the board
unnamed: J3.31 (AGINGEN), R26.1
unnamed: R18.1, U5.18 (B1)
unnamed: R19.1, U5.17 (B2)
unnamed: R20.1, U5.15 (B4)
PWR_OFF: U4.1 (D0_GPIO1); also elsewhere on the board
SPI_CS_N: R25.2, U4.2 (D1_GPIO0), U5.5 (A4)
SPI_MISO: U4.10 (D9_GPIO9), U5.4 (A3)
SPI_MOSI: U4.11 (D10_GPIO10), U5.3 (A2)
SPI_SCLK: U4.9 (D8_GPIO8), U5.2 (A1)
TCON_INT: U4.8 (D7_GPIO12), U5.6 (A5)
XIAO_5V: U4.14 (5V_VBUS); also elsewhere on the board

Notes on the sheet:
XIAO ESP32-C5 / 3.3 V SPI / IRIS 39-PIN FPC
Battery sense / GPIO5 bottom pad 16
Calibrate latch voltage drop.
Firmware BUS_EN / default isolated
No PG circuit. D2 / GPIO25 is unused.
Keep BUS_EN low until supply startup delay has elapsed.
USB-only debug: JP1 open, BUS_EN remains low.
CS idle ~3.15V; verify leakage / VIH.
NC / LVDS pins remain open.
SPI payload: IRIS commands + BGR888 pixels. Firmware controls bus enable.

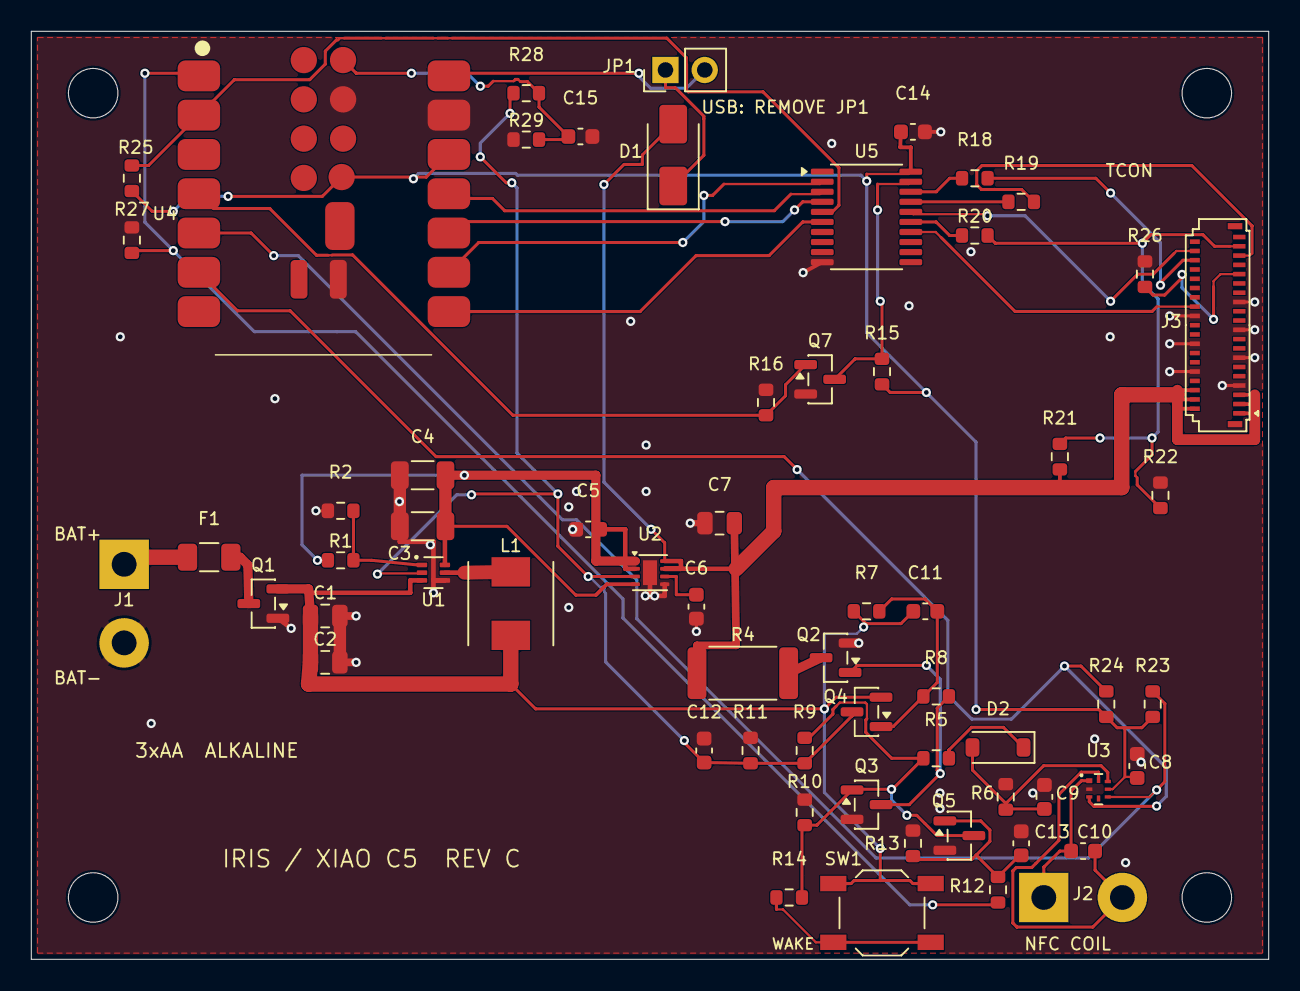
[picture p15: board IRIS_C5_RevC.kicad_pcb from above]

Board: 2 copper layers, 80.0 x 60.0 mm, 66 parts (0 on the bottom side), 43 nets.

Other parts of the board:
H1, H2, H3, H4: MountingHole_3.2mm_M3
