Benv-B/photo-frame-hardware/(commit log)

2026-10-16 Add RevC hardware with refilled GND zones after routing edits
    [02_NFC_Latch.kicad_sch, 03_Controller_FPC.kicad_sch, BOM.csv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]
2026-10-22 License carrier hardware and document ChLCD AirDrop prototype
